onceuponoleg/AetherCoreTerminalBestie/README.md

# 🪐 AetherCore Terminal Bestie // Cyberpunk IoT Weather, Aero, Planetary, ... Telemetry Terminal

Настольный гиковый киберпанк-прибор для локального мониторинга среды, атмосферных индексов, космической погоды и авиатрафика в радиусе 100 км. Устройство объединяет «аналоговый» мир комнаты с глобальной сетью таких же терминалов через децентрализованную синхронизацию.

## 🛠 Архитектурный стек проекта
* **Вычислительное ядро:** `ESP32-S3-DevKitC-1 (N16R8)` — 2 ядра Xtensa LX7 (240 МГц), 16 МБ Flash, 8 МБ Octal PSRAM.
* **Питание и защита:** Стационарное питание 5В от ПК или PowerBank через корпусной разъем **USB Type-C** (с подтяжкой 5.1 кОм на линиях CC1/CC2), предохранитель `PPTC Polyfuse 1.1A`[cite: 4] и плату расширения с винтовыми клеммами и буферными конденсаторами (`1000 мкФ` + `100 нФ`).
* **Дисплей:** Единый `3.5" / 4.0" IPS TFT (480x320, драйвер ST7796, SPI)`[cite: 4] с научно-фантастической биколорной палитрой (угольно-синий `#02080D`, ледяной циан `#00E5FF`, янтарный `#FF6B00`) и сквозной нижней строкой пейджер-чата.
* **Приборная подсветка:** Светодиодные нити накала **`LED Filament 3V`** (диаметр 1.3–1.5 мм), уложенные вдоль 2-мм рамок лицевой панели и управляемые через ШИМ-драйвер на MOSFET `AO3400` от отдельного энкодера.
* **Сенсорный комплекс:**
  * `ENS160 + AHT21` — газоанализатор ($eCO_2$, $TVOC$, индекс $AQI$) + температура и влажность[cite: 4].
  * `BMP280` — атмосферное давление и расчет 3-часового барического тренда (предсказание шторма)[cite: 4].
  * `Sharp GP2Y1014AU0F` — оптический инфракрасный анализатор пыли и аэрозолей ($\text{мкг/м}^3$).
  * `TCS34725` — спектральный состав света (R/G/B), освещенность (Lux), цветовая температура (Кельвины)[cite: 4].
  * `INMP441` — цифровой I2S-микрофон (уровень шума комнаты в дБА и частотный спектр).
  * `MPU6050` — 3-осевой сейсмо-акселерометр с дневным и ночным фильтрами вибраций здания[cite: 4].
* **Органы управления:** 3 энкодера с кнопками (`ENC_MODE` — режимы / Назад; `ENC_SUB` — подрежимы / ОК; `ENC_LIGHT` — диммер и Вкл/Выкл подсветки), 2 двухпозиционных тумблера (`SW_SRC` — Локалка / Сосед; `SW_NIGHT` — День / Ночь) и аналоговая ручка громкости со щелчком выключения.
* **Аудиосистема:** Процедурный генератор Lo-Fi / Sci-Fi эмбиента на базе I2S ЦАП `PCM5102A`, усилителя `PAM8403` (с потенциометром и выключателем) и динамика 40 мм (3 Вт).
* **Локальное хранилище:** MicroSD-карта (FAT32) для хранения конфигурации `/config.json`, предзагруженных векторных карт `/maps/*.vec` и кэша орбит TLE.
* **Сетевая синхронизация:** Бессерверный обмен JSON-пакетами через шлюз **Google Apps Script (`script.google.com`)**, работающий из любой точки мира, включая РФ, без VPN.

## 🖥 6 Режимов работы прибора
1. **[01 // INDOOR LAB] Локальная Телеметрия:** Химический и физический состав воздуха, расчетные индексы (точка росы, Humidex, барический тренд), оптический замер пыли, RGB-спектр света, шумомер и двухрежимный сейсмограф (+ сводка землетрясений USGS/EMSC)[cite: 4].
2. **[02 // WEATHER RADAR] Метео-Радар 100 км:** Векторная карта местности (100×100 км) с переключением погодных слоев (`Ветер` ➔ `Осадки/Грозы` ➔ `Температура/Изобары`) и подрежимом прогноза на `+3 часа` (Open-Meteo API).
3. **[03 // SPACE & ORBITAL] Орбитальный Трекер и Космос:** Живой расчет пролетов МКС и спутников (алгоритм SGP4 по TLE), фазы Луны, видимые планеты, космическая погода NOAA ($K_p$-индекс, солнечный ветер, рентгеновские вспышки)[cite: 4] и бегущая строка телеметрии SatNOGS.
4. **[04 // SKY TRAFFIC] Авиарадар (ADS-B):** Полярный радар воздушных судов в радиусе 100 км (`OpenSky` / `adsb.lol`) с захватом цели вторым энкодером и выводом полетной карточки борта.
5. **[05 // PLANETARY MATRIX] Сводная Матрица:** Крупный риалтайм-дашборд ключевых показателей и магнитуд своей или соседней станции без карт и прогнозов + карусель всех узлов сети[cite: 4].
6. **[06 // SYSTEM TERMINAL] Меню и Пейджер-Чат:** Полноэкранный терминал выбора активного соседа, отправки суточного сообщения в чат (ввод текста энкодером в стиле пультов ELRS), настройки частоты опроса и диагностики.

## 📂 Документация проекта
* [`docs/01_CONCEPT_AND_ARCHITECTURE.md`](docs/01_CONCEPT_AND_ARCHITECTURE.md) — Концепция, системная архитектура и распределение ядер FreeRTOS.
* [`docs/02_HARDWARE_BOM_AND_PINOUT.md`](docs/02_HARDWARE_BOM_AND_PINOUT.md) — Полный список деталей (BOM), пассивная обвязка и таблица пинов.
* [`docs/03_MODES_AND_UI_UX.md`](docs/03_MODES_AND_UI_UX.md) — Подробное описание всех 6 режимов, сквозного интерфейса и логики управления.
* [`docs/04_NETWORK_AND_SD_STORAGE.md`](docs/04_NETWORK_AND_SD_STORAGE.md) — Сетевой протокол Google Apps Script, структура JSON и файловая система SD-карты.
* [`docs/05_ENCLOSURE_AND_ERGONOMICS.md`](docs/05_ENCLOSURE_AND_ERGONOMICS.md) — Конструкция 3D-печатного корпуса, монтаж нитей LED Filament и изоляция датчиков.
* [`docs/06_WIRING_SCHEMATIC.md`](docs/06_WIRING_SCHEMATIC.md) — Полная электрическая схема (Mermaid-диаграмма, поблочные цепи и монтажный чек-лист).
