onceuponoleg/AetherCoreTerminalBestie/docs/01_CONCEPT_AND_ARCHITECTURE.md

# 01. Концепция и Архитектура Системы (Cyberpunk Telemetry Station)

## 1. Философия и назначение устройства
**AetherCoreTerminalBestie** задуман как настольный бортовой прибор наблюдения за локальной средой и окружающим пространством в эстетике олдскульного киберпанка и авиационных приборных панелей[cite: 4]. Главная задача гаджета — вызывать тактильный и визуальный восторг («вау-эффект»), позволяя физически ощущать параметры своей комнаты и одним щелчком тумблера «переноситься» в локацию друзей, подключенных к общей децентрализованной сети.

## 2. Ключевые инженерные решения и снятие ограничений

### 2.1. Вычислительная платформа (ESP32-S3 N16R8)
Отказ от одноплатников на Linux (Raspberry Pi) в пользу микроконтроллера **ESP32-S3 (16 МБ Flash, 8 МБ Octal PSRAM)** обеспечивает:
* **Мгновенный старт** (< 1 секунды после подачи питания).
* **Иммунитет к внезапному отключению питания:** выдергивание кабеля из ПК или PowerBank никогда не повредит файловую систему (в отличие от SD-карт с ОС Linux).
* **Плавную графику без мерцания:** наличие 8 МБ быстрой памяти PSRAM позволяет держать в оперативной памяти полные кадровые буферы (спрайты `480x320`), предзагруженные векторные карты и массив орбит спутников.

### 2.2. Энергетика и защита по питанию (5V USB Type-C)
Устройство работает стационарно от любого порта USB ПК или внешнего PowerBank (автономная батарея внутри корпуса не требуется):
* На заднюю стенку корпуса вынесен **навесной разъем USB Type-C** со встроенными резисторами `5.1 кОм` на линиях `CC1/CC2`, что гарантирует подачу 5В как от кабелей USB-A ➔ USB-C, так и от современных блоков и ноутбуков USB-C ➔ USB-C.
* Стабильное базовое потребление (экран + процессор ~220–300 мА) не позволяет PowerBank уходить в автоматический спящий режим.
* Для защиты слабого порта USB 2.0 компьютера (лимит 500 мА) от импульсных пиков тока при передаче по Wi-Fi и вспышках ИК-диода пылемера используется входной буфер (`1000 мкФ` + `100 нФ`) и самовосстанавливающийся предохранитель `PPTC Polyfuse 1.1A`[cite: 4].
* Разделение шин: силовая нагрузка (аудиоусилитель `PAM8403` и ИК-пылемер `GP2Y1014AU0F`) питается от шины `+5V` платы расширения, а чувствительная цифровая логика, датчики I2C, экран и нити подсветки — от стабилизированной шины `+3.3V`.

### 2.3. Сетевая архитектура «Соседей» без выделенного сервера
* Каждая сеть представляет собой открытую для скрипта папку на Google Диске администратора, к которой привязан веб-скрипт **Google Apps Script (`script.google.com`)**.
* Домен `script.google.com` работает по HTTPS напрямую из России и любой другой страны без блокировок ТСПУ и без сложной OAuth2-авторизации на микроконтроллере.
* Устройство может состоять сразу в нескольких сетях (список URL-адресов скриптов задается в `/config.json` на SD-карте). Список доступных соседних гаджетов формируется при загрузке как объединение множеств всех узлов из всех папок.
* При переключении тумблера `SW_SRC` в положение `REMOTE (Сосед)`:
  * **Режим 1 (Датчики)** и **Режим 5 (Матрица)** отображают живую телеметрию датчиков выбранного соседа.
  * **Режим 2 (Погодный радар)**, **Режим 3 (Космос)** и **Режим 4 (Авиарадар)** берут геокоординаты соседа (`lat`, `lon`) и перестраивают карты погоды, орбиты спутников и радар самолетов вокруг его точки планеты.

### 2.4. Концепция единого дисплея и постоянной строки чата
* Вся визуализация сосредоточена на одном экране **3.5"/4.0" IPS TFT (480x320)**[cite: 4].
* Верхние 24 пикселя (Статус-бар) и нижние 28 пикселей (Пейджер-строка «Сообщения дня») закреплены на экране постоянно во всех 6 режимах.
* Все функции настройки, выбора соседа и набора текста вынесены в **Режим 6 (Системный Терминал)**.

## 3. Программная архитектура (Распределение задач по ядрам ESP32-S3)

Прошивка строится на базе **FreeRTOS** с жестким разделением задач между двумя физическими ядрами процессора, чтобы сетевые запросы и генерация звука никогда не вызывали фризов интерфейса:

| Ядро процессора | Задачи FreeRTOS | Приоритет и частота | Описание работы |
| :--- | :--- | :--- | :--- |
| **Core 0 (`PRO_CPU`)** | `Task_AudioSynth` | Высокий (непрерывно, DMA I2S) | Процедурный синтез фонового Lo-Fi / Sci-Fi эмбиента и тематического шума (ветер, космос, эфир) с выводом в ЦАП `PCM5102A`. |
| **Core 0 (`PRO_CPU`)** | `Task_NetSync` | Низкий (раз в 5–60 сек) | Фоновые HTTPS-запросы к `script.google.com`, Open-Meteo, OpenSky и USGS. Парсинг JSON в PSRAM. |
| **Core 1 (`APP_CPU`)** | `Task_Controls_ISR` | Максимальный (по прерываниям) | Мгновенный опрос 3 энкодеров (`ENC_MODE`, `ENC_SUB`, `ENC_LIGHT`), 2 тумблеров и аппаратный ШИМ нитей накала `LED Filament`. |
| **Core 1 (`APP_CPU`)** | `Task_LocalSensors` | Средний (1 раз в сек / 200 Гц для MPU6050) | Опрос шины I2C, импульсный замер пыли `GP2Y1014AU0F`, БПФ спектра микрофона `INMP441` и фильтрация сейсмографа. |
| **Core 1 (`APP_CPU`)** | `Task_UI_Render` | Высокий (1–10 FPS по событию) | Отрисовка активного режима (1–6) в буфер PSRAM и быстрая пересылка кадра по SPI в экран `ST7796`. |
