onceuponoleg/AetherCoreTerminalBestie/docs/03_MODES_AND_UI_UX.md

# 03. Режимы Работы, Управление и Интерфейсы (UI/UX)

## 1. Визуальный стиль и разметка единого экрана (480x320)

Графический интерфейс стилизован под авиационно-космические бортовые панели с высокой читаемостью и строгой трехцветной палитрой:
* **Базовый фон (`#02080D`):** Глубокий угольно-синий (на IPS-матрице сливается с черной рамкой экрана).
* **Основная графика и сетки (`#00E5FF` / `#0A4A58`):** Яркий ледяной циан для цифр, векторов и графиков; приглушенный технический бирюзовый для координатных сеток, рамок и подписей.
* **Акцент и тревога (`#FF6B00`):** Янтарно-оранжевый для грозовых фронтов, превышения порогов $CO_2$/пыли, захваченной цели на радаре и индикации режима просмотра соседнего гаджета (`REMOTE`).

### Трехзонная архитектура экрана (480x320 px)
1. **Верхний сквозной статус-бар (`480 x 24 px` — закреплен всегда):**
   * *Слева:* Номер и код активного режима (`[01 // INDOOR LAB]` .. `[06 // SYS TERMINAL]`).
   * *По центру:* Индикатор источника данных по положению тумблера `SW_SRC`:
     * `● SRC: LOCAL [HOME]` (голубая плашка) — данные со своих датчиков и своих координат.
     * `◆ SRC: REMOTE [<ИМЯ_СОСЕДА>]` (янтарно-оранжевая плашка) — данные и координаты выбранного друга из сети.
   * *Справа:* Статус подсветки нитей (`FIL: 60%`), период синхронизации (`SYNC: 5s`), уровень сигнала Wi-Fi и часы.
2. **Центральное рабочее поле (`480 x 268 px`):**
   * Меняется в зависимости от выбранного режима (1–6).
3. **Нижняя сквозная пейджер-строка (`480 x 28 px` — закреплена всегда):**
   * Отображает последнее полученное за сутки сообщение из сетевого чата (имя отправителя, время и текст до 70–100 символов). Пока ты смотришь погоду, спутники или датчики, сообщение от друга всегда перед глазами как «телеграмма дня».

## 2. Полная матрица управления (3 Энкодера + 2 Тумблера + Громкость)

| Орган управления | Действие | Поведение в Режимах 1–5 (Дашборды и Радары) | Поведение в Режиме 6 (Системный Терминал и Чат) |
| :--- | :--- | :--- | :--- |
| **Энкодер 1 (`ENC_MODE`)** | **Вращение** | Переключает по кругу главные режимы: `1 ➔ 2 ➔ 3 ➔ 4 ➔ 5 ➔ 6`. | Переключает по кругу главные режимы (выход из терминала в режимы 1–5). |
| **Энкодер 1 (`ENC_MODE`)** | **Клик (SW)** | Переключает **вторичный вид** режима (Погода: `Сейчас ↔ Прогноз +3ч`; Космос/Авиа: `Радар ↔ Таблица`). | Работает как **`НАЗАД / ESC`** (выход в предыдущее меню или удаление последней введенной буквы `Backspace`). |
| **Энкодер 2 (`ENC_SUB`)** | **Вращение** | Переключает **подрежимы**: графики (Реж. 1), погодные слои карты (Реж. 2), прицел выбора спутника/самолета (Реж. 3–4), карусель соседей (Реж. 5). | Листает строки меню, список станций сети или крутит курсор по алфавитной матрице при наборе сообщения. |
| **Энкодер 2 (`ENC_SUB`)** | **Клик (SW)** | Фиксация цели на радаре / сброс пиков графика. | Работает как **`ОК / ВВОД`** (вход в пункт меню, выбор соседа, добавление буквы в строку чата, нажатие `[ОТПРАВИТЬ]`). |
| **Энкодер 3 (`ENC_LIGHT`)** | **Вращение** | Плавная регулировка яркости нитей накала `LED Filament 3V` от `5%` до `100%` (шаг 5%). | Аналогично (работает глобально всегда). |
| **Энкодер 3 (`ENC_LIGHT`)** | **Клик (SW)** | Плавное включение / выключение подсветки `LED Filament 3V` (`Fade-In / Fade-Out`). | Аналогично (работает глобально всегда). |
| **Тумблер 1 (`SW_SRC`)** | **2 позиции** | `ВНИЗ`: Локальная станция (`LOCAL`).<br>`ВВЕРХ`: Выбранный сосед из сети (`REMOTE`). | Отображает текущий статус тумблера в шапке экрана. |
| **Тумблер 2 (`SW_NIGHT`)** | **2 позиции** | `ВНИЗ`: Дневной режим (100% яркость экрана).<br>`ВВЕРХ`: Ночной режим (приглушенная ШИМ-подсветка). | Аналогично (работает глобально всегда). |
| **Потенциометр (`VOL`)** | **Вращение + Щелчок** | Плавная аналоговая громкость фонового эмбиента. Крайнее левое положение со щелчком — физическое отключение усилителя `PAM8403`. | Аналогично (полностью аппаратное управление). |

## 3. Детальное описание всех 6 режимов

### Режим 1: `[01 // INDOOR LAB]` — Локальная Телеметрия и Лаборатория Среды
Экран разбит на приборные модули (если какой-то датчик не подключен или отсутствует у выбранного соседа, в его ячейке выводится инженерная заглушка `[ MODULE OFFLINE // N/A ]`):
1. **Блок Атмосферы и Комфорта (`AHT21 + BMP280`):**
   * Температура (°C), относительная влажность (%) и давление (мм рт. ст. / гПа)[cite: 4].
   * **Расчетные индексы:** Точка росы (`Dew Point`), индекс теплового комфорта (`Humidex`) и **3-часовой барический тренд** ($\Delta P$, например `-2.4 мм/3ч — ШТОРМОВОЕ ПАДЕНИЕ`)[cite: 4].
2. **Блок Химии и Аэрозолей (`ENS160 + GP2Y1014AU0F`):**
   * Концентрация углекислого газа $eCO_2$ (400–5000 ppm), летучих органических веществ $TVOC$ (ppb) и сводный индекс качества воздуха `AQI (1..5)`[cite: 4].
   * Плотность взвешенной пыли и смога в $\text{мкг/м}^3$ с оптического ИК-сенсора.
3. **Блок Оптического Спектра и Акустики (`TCS34725 + INMP441`):**
   * Три вертикальных столбика спектрального баланса света (`Red / Green / Blue`), освещенность в Люксах (`Lux`) и цветовая температура источника света в Кельвинах (`CCT`, например `3200K Warm` или `6500K Monitor Blue`)[cite: 4].
   * Уровень акустического шума комнаты в децибелах (`dBA`) + 8-полосный мини-спектроанализатор звука в реальном времени.
4. **Блок Сейсмографии и Тверди (`MPU6050` + API USGS/EMSC):**
   * Живая бегущая сейсмограмма в нижней части рабочей зоны[cite: 4].
   * **Двухрежимный фильтр по времени суток:**
     * *Дневной режим (`08:00 – 22:00`, метка `FILTER: DAY COARSE`):* Загрубленный фильтр, отсекающий бытовые касания стола и клавиатуры (показывает общий индекс механической активности среды).
     * *Ночной режим (`22:00 – 08:00`, метка `FILTER: NIGHT HIGH-GAIN`):* Узкополосный фильтр (0.5–8 Гц) максимальной чувствительности для фиксации микроколебаний и резонанса здания в ночной тишине[cite: 4].
   * Справа от осциллограммы выводится сводка реальных землетрясений в радиусе 500 км из открытого API USGS/EMSC (магнитуда, глубина, удаление от станции)[cite: 4].
* **Подрежимы (вращение `ENC_SUB`):** Переключает крупный нижний график между `1. Сейсмограф + USGS` ➔ `2. Суточный график eCO2 и Пыли` ➔ `3. Развернутый спектр света и шума`[cite: 4].

### Режим 2: `[02 // WEATHER RADAR 100KM]` — Метео-Радар и Прогноз
* **Векторная карта местности (100×100 км):** Читается за 0.1 сек из бинарного файла `/maps/local_100km.vec` (или `/maps/neighbor_<id>.vec`) на MicroSD-карте. Отрисовывает береговые линии рек/озер/морей, основные автомагистрали и изолинии высот тонкими бирюзовыми линиями, в центре — перекрестие станции и кольца дальности 25, 50 км.
* **Погодные слои (переключаются вращением `ENC_SUB` по данным сетки $5 \times 5$ точек Open-Meteo API):**
  1. **`LAYER 1: WIND STREAMLINES`** — анимированные векторные стрелки направления и скорости ветра + боковая сводка ветра по высотам (10 м, 80 м, 1500 м)[cite: 4].
  2. **`LAYER 2: PRECIPITATION & STORM CAPE`** — зоны осадков (дождь/снег растровой штриховкой разной плотности), процент облачности и индекс грозовой энергии `CAPE` (опасные ячейки подсвечиваются янтарным `#FF6B00`).
  3. **`LAYER 3: THERMO & ISOBARS`** — интерполированные изотермы температуры и изобары приземного давления.
* **Подрежим Прогноза (`Клик ENC_MODE`):** Мгновенно переключает радар из состояния `LIVE (СЕЙЧАС)` в состояние **`FORECAST +3 HOURS (ПРОГНОЗ ЧЕРЕЗ 3 ЧАСА)`**. Карта перестраивается по прогнозному срезу Open-Meteo, наглядно показывая смещение фронта осадков, поворот ветра и изменение температуры на 3 часа вперед.

### Режим 3: `[03 // SPACE & ORBITAL]` — Орбитальный Трекер и Глубокий Космос
Работает в реальном времени с обновлением координат 1 раз в секунду:
* **Спутники над головой (SGP4 + TLE):** В левой части экрана — полярная проекция небосвода над станцией (зенит в центре, горизонт по кругу). На ней в реальном времени движутся метки и траектории пролета ~25 ключевых спутников (МКС[cite: 4], станция «Тяньгун», телескоп Hubble, метеоспутники NOAA/Meteor[cite: 4], цепочки Starlink, радиолюбительские спутники).
* **Объекты Солнечной системы и Навигационные звезды:** Аналитический расчет (без интернета, по координатам и времени UTC) положения Солнца, Луны (с графической отрисовкой текущей фазы и процента освещенности)[cite: 4], видимых планет (Венера, Марс, Юпитер, Сатурн) и 12 ярчайших навигационных звезд (Сириус, Вега, Арктур, Полярная и др.) без перегрузки каталогами Мессье/NGC.
* **Панель Космической Погоды (справа, данные NOAA SWPC):**
  * Скорость солнечного ветра (км/с) и плотность протонов ($p/\text{см}^3$)[cite: 4].
  * Планетарный геомагнитный индекс **$K_p$ (0..9)** с цветовой индикацией магнитных бурь (`G1–G5`)[cite: 4].
  * Текущий класс рентгеновских вспышек на Солнце (`A / B / C / M / X`)[cite: 4].
* **Связь с реальным космосом (Telemetry Ticker):** Бегущая строка перехвата реальных пакетов радиолюбительских спутников и статуса МКС из открытого API `SatNOGS / ARISS`.
* **Управление в режиме:** Вращение `ENC_SUB` перебирает объекты на небе в прицел захвата и выводит карточку аппарата (название, назначение, высота орбиты в км, скорость км/с, азимут и угол места). Клик `ENC_MODE` переключает вид `КАРТА НЕБА ↔ ТАБЛИЦА БЛИЖАЙШИХ ПРОЛЕТОВ`[cite: 4].

### Режим 4: `[04 // SKY TRAFFIC ADS-B]` — Авиарадар Воздушного Пространства
* **Источник данных:** Открытые API `adsb.lol` / `adsb.fi` / `OpenSky Network` (все воздушные суда с транспондерами ADS-B в радиусе 100 км от выбранной станции).
* **Визуализация:** Круговой радар ПВО/УВД с кольцами 25, 50, 100 км, азимутальной шкалой и плавным лучом развертки. Каждое судно отображается иконкой с вектором путевой скорости.
* **Захват цели (`Вращение ENC_SUB`):** Перемещает янтарную рамку захвата между самолетами/вертолетами на радаре. Сбоку выводится детальная карточка борта:
  * Позывной / Рейс (например, `KZR921`), страна регистрации и авиакомпания.
  * Тип воздушного судна (`B738`, `A321`, `B77W`, `MI8`, `C172`).
  * Барометрическая высота (в метрах), путевая скорость (км/ч) и вертикальная скорость (набор/снижение м/с).
  * Прямое расстояние до борта (км) и азимут из окна комнаты.
* **Смена вида (`Клик ENC_MODE`):** Переключает `КРУГОВОЙ РАДАР ↔ СВОДНАЯ ТАБЛИЦА БОРТОВ`.

### Режим 5: `[05 // PLANETARY MATRIX]` — Сводная Матрица Показателей
Чистый, высококонтрастный приборный дашборд без карт, радаров и прогнозов — только ключевые риалтайм-показатели и индексы крупным шрифтом (идеально читается с расстояния 3–5 метров)[cite: 4]:
* Крупные цифровые блоки: **Температура**, **Влажность**, **Давление + Тренд**, **Индекс воздуха AQI / $eCO_2$**, **Пыль ($\text{мкг/м}^3$)**, **Шум (дБА)**, **Сейсмо-пик (g)** и **Геомагнитный $K_p$-индекс**[cite: 4].
* **Карусель сети (`Вращение ENC_SUB`):** Позволяет быстро листать сводные карточки всех станций друзей, присутствующих в сети, сравнивая их условия жизни в один поворот ручки.

### Режим 6: `[06 // SYSTEM TERMINAL]` — Меню, Сеть и Пейджер-Чат
Полноэкранный терминал управления станцией:
1. **`[ 1. ВЫБОР СТАНЦИИ СОСЕДА (NETWORK NODES) ]`:**
   * Выводит список всех обнаруженных в папках Google Диска гаджетов (Имя станции, ID сети, статус `ONLINE/OFFLINE`, время последнего дампа, расстояние в км).
   * Клик `ENC_SUB (OK)` назначает выбранную станцию активным «Соседом» (к ней прибор будет мгновенно обращаться при переключении тумблера `SW_SRC` вверх).
2. **`[ 2. ОТПРАВИТЬ СООБЩЕНИЕ ДНЯ (PAGER TX) ]`:**
   * Выбор адресата: `BROADCAST (ВСЕМ В СЕТИ)` или конкретный гаджет из списка.
   * **Клавиатура в стиле пультов ELRS:** На экране рисуется строка ввода (до 80 символов) и лента символов (`А-Я`, `A-Z`, `0-9`, знаки препинания). Вращение `ENC_SUB` двигает рамку по буквам, клик `ENC_SUB` — печатает букву, клик `ENC_MODE` — стирает последний символ (`Backspace`).
   * Выбор кнопки `[ TRANSMIT ]` отправляет сообщение в облачный скрипт и включает суточный таймер перезарядки (`TX COOLDOWN: 23h 59m`), делая каждое сообщение ценной телеграммой.
3. **`[ 3. ЧАСТОТА СИНХРОНИЗАЦИИ (SYNC RATE) ]`:**
   * Выбор интервала сетевого обновления данных: **`5 сек` (минимум для режима соседа)**, **`10 сек`**, **`30 сек`** или **`60 сек`**.
4. **`[ 4. ГЕОКООРДИНАТЫ И ДИАГНОСТИКА (SYSTEM & GPS) ]`:**
   * Поразрядный ввод/корректировка своих координат (`LAT`, `LON`, `ALT`) энкодерами с сохранением в `/config.json`.
   * Таблица диагностики шины I2C (статус каждого датчика `OK / MISSING`), тест звука и свободное место на MicroSD-карте.

## 4. Процедурная аудио-система (Data-Driven Lo-Fi / Sci-Fi Ambient)

На ядре `Core 0` работает легкий математический синтезатор звука, выводящий 16-битный поток 22050 Гц через ЦАП `PCM5102A` на усилитель `PAM8403`:
* **Тематический атмосферный фон (Drone):**
  * В *Режиме 1 и 5* — едва слышный теплый виниловый/ламповый уют.
  * В *Режиме 2 (Погода)* — процедурный шелест ветра (фильтр розового шума, частота среза которого плавно растет вместе с реальной скоростью ветра за окном!).
  * В *Режиме 3 (Космос)* — глубокий космический гул палубы корабля и редкие мягкие бипы при пролете спутника через зенит.
  * В *Режиме 4 (Авиарадар)* — тихая атмосфера диспетчерской вышки.
* **Генеративная Lo-Fi мелодия:** Медленный секвенсор играет мягкие аккорды электропиано в пентатонике. Каждые **5 минут** алгоритм плавно меняет корневую тональность, темп и паттерн арпеджио, поэтому мелодия никогда не зацикливается и не надоедает.
