onceuponoleg/AetherCoreTerminalBestie/docs/02_HARDWARE_BOM_AND_PINOUT.md

# 02. Спецификация Железа, Питание и Распиновка (Hardware & BOM)

## 1. Полная спецификация модулей (Bill of Materials)

| Категория | Компонент / Модуль | Назначение | Параметры и примечания к покупке |
| :--- | :--- | :--- | :--- |
| **Мозг** | `ESP32-S3-DevKitC-1 (N16R8)` | Главный микроконтроллер | Строго версия **N16R8** (16MB Flash, 8MB Octal PSRAM). |
| **База** | `ESP32-S3 Breakout Shield` | Плата расширения с клеммами | Screw Terminal Breakout Board под 44-pin ESP32-S3. |
| **Питание** | Навесной разъем `USB Type-C` | Внешний вход питания 5V на корпусе | Panel-mount Type-C (на мини-платке с резисторами 5.1 кОм на CC1/CC2). |
| **Дисплей** | `3.5" / 4.0" IPS TFT (ST7796)` | Единый экран прибора + SD-слот | Разрешение `480x320`, матрица **IPS** (широкие углы обзора), шина SPI, со слотом MicroSD на плате. |
| **Память** | `MicroSD Card (2–16 GB)` | Хранение конфига, векторных карт и кэша | Форматируется в `FAT32`. |
| **Климат и Газ** | `ENS160 + AHT21` (2-в-1) | $eCO_2$, $TVOC$, $AQI$ + Темп. и Влажность | Сдвоенный модуль на шине I2C (питание 3.3V)[cite: 4]. |
| **Барометр** | `BMP280` (3.3V) | Атмосферное давление и барический тренд | Модуль I2C (`0x76` или `0x77`). |
| **Пылемер** | `Sharp GP2Y1014AU0F` | Оптический ИК-анализатор взвешенной пыли | Поставляется в комплекте с резистором `150 Ом` и конденсатором `220 мкФ`. |
| **Свет и Цвет** | `TCS34725` | RGB-спектр света, Люксы, Цветовая темп. (К) | Модуль I2C (`0x29`). Пин `LED` замкнуть на `GND`. |
| **Шумомер** | `INMP441` | Уровень шума (дБА) и частотный спектр | Всенаправленный цифровой I2S MEMS-микрофон (3.3V). |
| **Сейсмограф** | `MPU6050` (GY-521) | Вибрации стола и сейсмо-резонанс здания | 3-осевой акселерометр + гироскоп на шине I2C (`0x68`)[cite: 4]. |
| **Аудио-ЦАП** | `PCM5102A` (I2S DAC) | Линейный аудиовыход для эмбиента | Модуль I2S DAC (24-bit, 3.3V/5V). |
| **Усилитель** | `PAM8403` с потенциометром | Усиление звука + ручка громкости с вкл/выкл | Плата **со встроенным переменным резистором и механическим щелчком выключения**. |
| **Динамик** | Динамик `40 мм (3 Вт, 4 Ом)` | Вывод фонового эмбиента | Широкополосный мини-динамик. |
| **Подсветка** | `LED Filament 3V` (2–4 шт.) | Подсветка приборных рамок на панели | Гибкие или жесткие светодиодные нити накала, диаметр `1.3–1.5 мм`, длина `38 мм` или `68 мм`, напряжение `3V`. |
| **Ключ света** | N-MOSFET `AO3400` / `IRLZ44N` | ШИМ-диммирование нитей накала | Транзистор с логическим уровнем открытия Gate (2.5V–3.3V) или готовый мини-модуль MOSFET Switch. |
| **Управление** | Энкодеры `EC11` (3 шт.) | `ENC_MODE`, `ENC_SUB`, `ENC_LIGHT` | Круговой энкодер с тактильными отсечками и нажимной кнопкой (SW). |
| **Управление** | Тумблеры `МТВ /MTS-102` (2 шт.)| `SW_SRC` (Локалка/Сосед), `SW_NIGHT` (День/Ночь)| Металлические 2-позиционные тумблеры (`ON-ON` или `ON-OFF`, 6 мм). |

## 2. Полный перечень навесных пассивных компонентов («Мелочь и обвязка»)

| № | Позиция на схеме | Тип и номинал детали | Кол-во | Точное назначение и место установки |
| :- | :--- | :--- | :--- | :--- |
| 1 | `F1` | Самовосстанавливающийся предохранитель **`PPTC Polyfuse 1.1A`** | 1 шт. | Впаивается в разрыв плюсового провода `+5V` между входным разъемом USB Type-C и клеммой `5V` платы расширения. Защищает порт ПК и проводку от КЗ[cite: 4]. |
| 2 | `C1` | Электролитический конденсатор **`1000 мкФ (10V или 16V)`** | 1 шт. | Зажимается ножками напрямую в винтовые клеммы `5V (+)` и `GND (-)` платы расширения. Сглаживает пики потребления Wi-Fi и ИК-диода. |
| 3 | `C2` | Керамический конденсатор **`100 нФ (0.1 мкФ, маркировка 104)`** | 1 шт. | Зажимается параллельно с `C1` в клеммы `5V` и `GND`. Гасит высокочастотные цифровые помехи. |
| 4 | `C3` | Электролитический конденсатор **`470 мкФ (10V)`** | 1 шт. | Припаивается непосредственно к площадкам питания `+5V` и `GND` на плате аудиоусилителя `PAM8403`. Полностью устраняет цифровой писк и шорох в динамике при работе экрана и Wi-Fi. |
| 5 | `R_LED`, `C_LED` | Резистор **`150 Ом`** + Электролит **`220 мкФ (10V)`** | 1 компл. | **Идут в пакетике с датчиком пыли `GP2Y1014AU0F`.** Пин 1 (`V-LED`) подключается к шине `+5V` через резистор `150 Ом`, а конденсатор `220 мкФ` ставится между пином 1 (`V-LED`) и `GND`. |
| 6 | `R_DIV1`, `R_DIV2` | Резисторы **`10 кОм (0.25 Вт, 1%)`** | 2 шт. | **Защитный делитель напряжения АЦП.** Пылемер питается от 5V и выдает на пин `Vo` до 4.0V. Делитель из двух резисторов по `10 кОм` делит сигнал пополам (до безопасных $\le 2.0\text{ V}$) перед подачей на `GPIO 1` чипа ESP32-S3. |
| 7 | `R_FIL1..3` | Резисторы **`10 Ом (0.5 Вт)`** | 2–4 шт. | Индивидуальные токоограничивающие балласты последовательно с каждой нитью `LED Filament 3V` при питании от шины `3.3V`. Защищают нити от перегрева и выравнивают их свечение. |
| 8 | `R_G`, `R_PD` | Резистор затвора **`100 Ом`** + Подтяжка **`10 кОм`** | по 1 шт. | Обвязка затвора MOSFET-транзистора (`GPIO 46` ➔ `100 Ом` ➔ `Gate`; `Gate` ➔ `10 кОм` ➔ `GND`). *Если используется готовый модуль MOSFET на платке, эти два резистора уже стоят на нем.* |

## 3. Сводная таблица распределения пинов (ESP32-S3 N16R8)

> **⚠️ Внимание:** На модулях ESP32-S3 с памятью Octal PSRAM (версия **N16R8**) пины **`GPIO 35`, `GPIO 36`, `GPIO 37`** физически заняты внутри модуля под шину памяти PSRAM — подключать к ним ничего нельзя! Пин **`GPIO 1`** выбран для датчика пыли, так как он относится к первому блоку АЦП (`ADC1_CH0`), который стабильно работает одновременно с Wi-Fi.

| Пин ESP32-S3 | Функциональная роль | Устройство / Контакт модуля | Примечание по электрике |
| :--- | :--- | :--- | :--- |
| **`GPIO 1`** | `ADC1_CH0` (Аналоговый вход) | Пылемер `GP2Y1014AU0F` — средняя точка делителя от пина `Vo (Pin 5)` | Вход через делитель `10 кОм / 10 кОм` (0..2.0V). |
| **`GPIO 2`** | `I2S_1_DOUT` (Звук ЦАП) | ЦАП `PCM5102A` — пин `DIN` | Поток аудиоданных синтезатора эмбиента. |
| **`GPIO 3`** | Дискретный вход (`INPUT_PULLUP`) | Энкодер 3 (`ENC_LIGHT`) — кнопка `SW` | Клик на `GND` = Вкл/Выкл подсветку `LED Filament`. |
| **`GPIO 4`** | `I2S_0_WS` (Микрофон) | Микрофон `INMP441` — пин `WS` | Выбор канала (пин `L/R` микрофона на `GND`). |
| **`GPIO 5`** | `I2S_0_SCK` (Микрофон) | Микрофон `INMP441` — пин `SCK` | Тактирование микрофона. |
| **`GPIO 6`** | `I2S_0_SD` (Микрофон) | Микрофон `INMP441` — пин `SD` | Цифровые данные с микрофона-шумомера. |
| **`GPIO 7`** | Цифровой выход (`OUTPUT`) | Пылемер `GP2Y1014AU0F` — пин `LED (Pin 3)` | Импульс 0.32 мс для вспышки ИК-диода. |
| **`GPIO 8`** | Шина `I2C_SDA` | Параллельно: `ENS160+AHT21`, `BMP280`, `MPU6050`, `TCS34725` | Линия данных I2C (3.3V, подтяжка на модулях). |
| **`GPIO 9`** | Шина `I2C_SCL` | Параллельно: `ENS160+AHT21`, `BMP280`, `MPU6050`, `TCS34725` | Линия тактирования I2C (3.3V). |
| **`GPIO 10`** | `SPI_CS_TFT` | Экран `IPS TFT ST7796` — пин `CS` | Выбор кристалла экрана. |
| **`GPIO 11`** | `SPI_MOSI` | Экран `TFT [SDI/MOSI]` + Слот `MicroSD [MOSI]` | Общая линия данных SPI. |
| **`GPIO 12`** | `SPI_SCK` | Экран `TFT [SCK]` + Слот `MicroSD [SCK]` | Общая линия тактирования SPI (40 МГц). |
| **`GPIO 13`** | `SPI_MISO` | Экран `TFT [SDO/MISO]` + Слот `MicroSD [MISO]` | Чтение данных с MicroSD-карты. |
| **`GPIO 14`** | `TFT_DC` | Экран `IPS TFT ST7796` — пин `DC (RS)` | Выбор Команда / Данные экрана. |
| **`GPIO 15`** | Вход энкодера (`INPUT_PULLUP`) | Энкодер 1 (`ENC_MODE`) — пин `CLK (A)` | Переключение режимов 1..6. |
| **`GPIO 16`** | Вход энкодера (`INPUT_PULLUP`) | Энкодер 1 (`ENC_MODE`) — пин `DT (B)` | Переключение режимов 1..6. |
| **`GPIO 17`** | Вход кнопки (`INPUT_PULLUP`) | Энкодер 1 (`ENC_MODE`) — пин `SW` | Клик: `НАЗАД / ESC` в меню или смена вида экрана. |
| **`GPIO 18`** | Вход энкодера (`INPUT_PULLUP`) | Энкодер 2 (`ENC_SUB`) — пин `CLK (A)` | Подрежимы / Слои карты / Навигация меню и чата. |
| **`GPIO 19`** | Вход энкодера (`INPUT_PULLUP`) | Энкодер 3 (`ENC_LIGHT`) — пин `CLK (A)` | Диммирование яркости `LED Filament` (5..100%). |
| **`GPIO 20`** | Вход энкодера (`INPUT_PULLUP`) | Энкодер 3 (`ENC_LIGHT`) — пин `DT (B)` | Диммирование яркости `LED Filament` (5..100%). |
| **`GPIO 21`** | `TFT_RST` | Экран `IPS TFT ST7796` — пин `RST` | Аппаратный сброс экрана. |
| **`GPIO 38`** | `SPI_CS_SD` | Слот `MicroSD` (на плате экрана) — пин `SD_CS` | Выбор MicroSD-карты на шине SPI. |
| **`GPIO 39`** | Вход энкодера (`INPUT_PULLUP`) | Энкодер 2 (`ENC_SUB`) — пин `DT (B)` | Подрежимы / Слои карты / Навигация меню и чата. |
| **`GPIO 40`** | Вход кнопки (`INPUT_PULLUP`) | Энкодер 2 (`ENC_SUB`) — пин `SW` | Клик: `ОК / ВЫБРАТЬ` в меню и ввод буквы в чате. |
| **`GPIO 41`** | `I2S_1_BCK` (Звук ЦАП) | ЦАП `PCM5102A` — пин `BCK` | Битовая синхронизация I2S ЦАП. |
| **`GPIO 42`** | `I2S_1_WS` (Звук ЦАП) | ЦАП `PCM5102A` — пин `LCK (WS)` | Кадровая синхронизация I2S ЦАП. |
| **`GPIO 45`** | Вход тумблера (`INPUT_PULLUP`) | Тумблер 2 (`SW_NIGHT`) — средний контакт | Разомкнут = `DAY`, замкнут на `GND` = `NIGHT`. |
| **`GPIO 46`** | Выход ШИМ (`LEDC_PWM 5kHz`) | Затвор (`Gate`) MOSFET-ключа `AO3400` | Через резистор `100 Ом` (плюс подтяжка `10 кОм` на `GND`). |
| **`GPIO 47`** | Вход тумблера (`INPUT_PULLUP`) | Тумблер 1 (`SW_SRC`) — средний контакт | Разомкнут = `LOCAL`, замкнут на `GND` = `REMOTE (Сосед)`. |
| **`GPIO 48`** | Выход ШИМ (`LEDC_PWM 20kHz`) | Экран `IPS TFT ST7796` — пин `BLK (LED)` | Плавное управление подсветкой экрана День / Ночь. |
