onceuponoleg/AetherCoreTerminalBestie/(list of files, cad)

Other CAD files:
3d/enclosure.scad
