onceuponoleg/AetherCoreTerminalBestie/(commit log)

2026-11-04 Uploaded enclosure v1
    [enclosure.scad]
2026-11-04 Move enclosure.scad to 3d/enclosure.scad
    [enclosure.scad]
2026-11-04 Uploaded enclosure preview
